TrevM309/RC8266_RCController_PCB_RcCtl/RcCtlHwParts.xlsx

Ref | Description | Name | Package | Num | Got | Source | Order | Cost £ | Price | got | onorder
U1 | Charging IC | TP4056 | SOP-8 | 1 | y | AliExpress | 20 | 0.76 | 0.038 | 18
U2 | Main IC | ESP-M2 | ESP-M2 | 1 | y | AliExpress | 1 | 1.11 | 1.11 | 6
U3 | I2C to 4 x ADC | ADS1015 | MSOP10 | 1 | y | AliExpress | 5 | 4.35 | 0.87 | 3 | 20 | aliexpress
V1 | 3V3 regulator | BA033CC0FP-E2 | TO252-3 | 1 | y | Farnell | 1 | 0.87 | 0.87 | 1 | 10 | farnell
V2 | 2V8 regulator | MIC5365-2.8YC5-TR | SC-70-5 | 1 | y | Farnell | 5 | 0.56 | 0.112 | 2 | 10 | farnell
D1 | RGB common cathode LED |  | 5mm | 1 | y | AliExpress | 100 | 7.19 | 0.0719 | 98
R1,3 | 1K2 Resistor | MCWR08X1201FTL | 0805 | 2 | y | Farnell | 1 | 0.008 | 0.016 | 15
R2 | 0R4 1/2w Resistor | WW25PR400FTL | 2512 | 1 | y | Farnell | 10 | 3.75 | 0.375 | 6
R6,7,8 | 10K Resistor | 2074334 | 0805 | 5 | y | Farnell | 10 | 0.195 | 0.0975 | 23
C1,2,3,4 | 10uF 10V Capacitor | C2012X6S1A106K085AC | 0805 | 4 | y | Farnell | 10 | 0.54 | 0.216 | 2 | 10 | farnell
C5,6 | 100nF Capacitor | MC0805B104M500CT | 0805 | 2 | y | Farnell | 10 | 0.52 | 0.104 | 13
BT1 | 3V7 LiPo Battery | 652338 6.5*23*38mm |  | 1 | y | AliExpress | 2 | 4.64 | 2.32 | 3
SW1 | Small slide switch |  |  | 1 | y | BangGood | 10 | 2.44 | 0.244 | lots
RV1,2 | Joystick |  |  | 1 | y | BangGood | 1 | 2.26 | 2.26 | 2 | 6 | aliexpress
J1 | Mini USB connector |  |  | 1 | y | Ebay | 10 | 1.31 | 0.131 | 7
J2 | Program port | 5 pin header |  | 0.12 | y | BangGood | 10 | 1.63 | 0.020375 | lots
J3 | LCD flexi connector | TE 2328702-8-FFC/FPC |  | 1 | y | Farnell | 5 | 0.86 | 0.172 | 2 | 10 | farnell
J3 | 0.96" 80x160 IPS TFT |  |  | 1 | y | AliExpress | 2 | 2.66 | 1.33 | sipeed langan nano | 5 | aliexpress
 |  |  |  |  |  |  |  |  | 10.357775
