TrevM309/RC8266_RCController_PCB_RcCtl/RcCtlHw.kicad_pcb

## KiCad design RcCtlHw.kicad_pcb (2021-08-10)

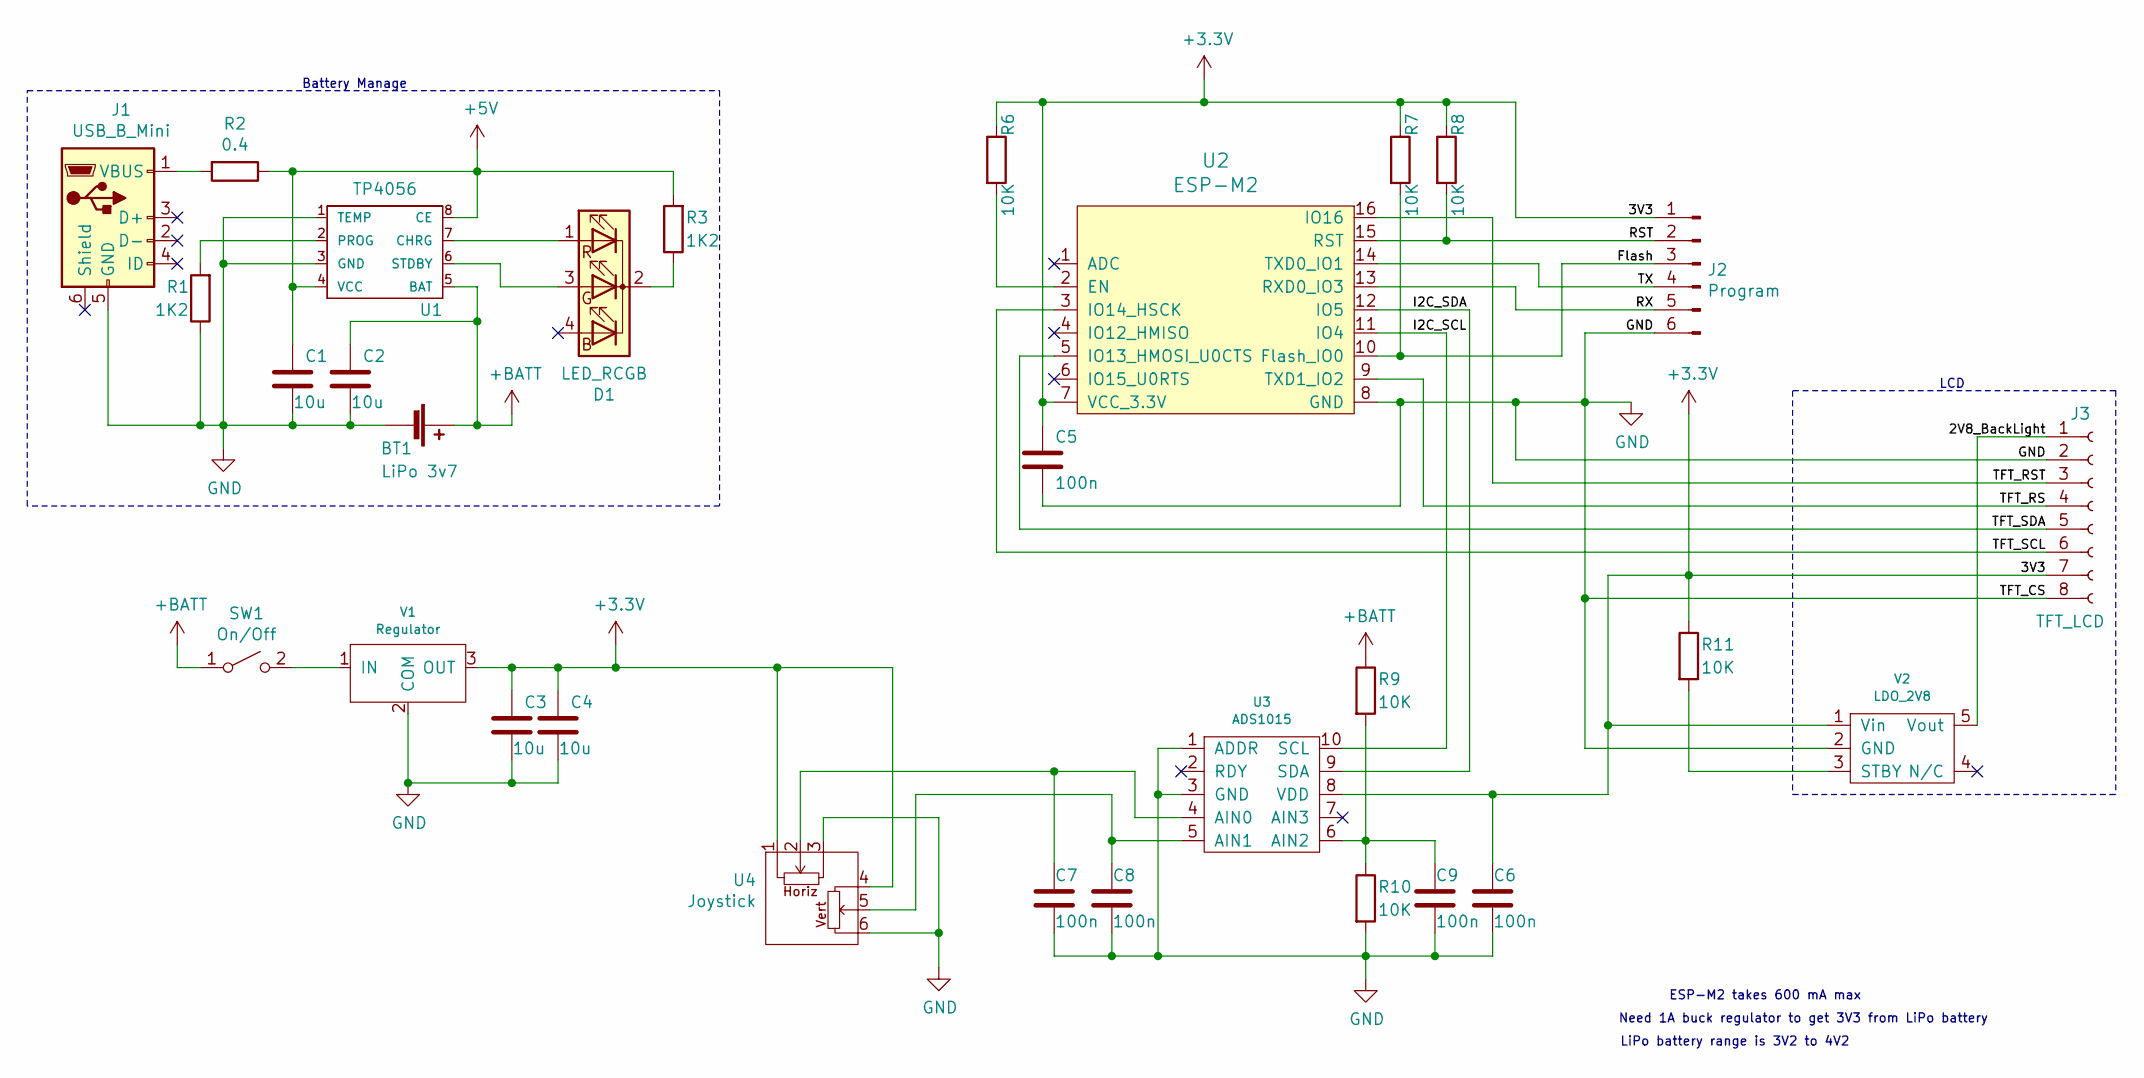
[picture p1: schematic RcCtlHw.sch]

Parts:
BT1: LiPo 3v7; PinHeader_1x02_P2.54mm_Vertical
C1, C2, C3, C4: 10u; C_0805_2012Metric
C5, C6, C7, C8, C9: 100n; C_0805_2012Metric
D1: LED_RCGB; LED_D5.0mm-4_RGB-RIGHT
J1: USB_B_Mini; USB_micro
J2: Program; PinHeader_1x06_P2.54mm_Vertical_bent
J3: TFT_LCD; 8w_FFC_conn
R1, R3: 1K2; R_0805_2012Metric
R2: 0.4; R_2512_6332Metric
R6, R7, R8, R9, R10, R11: 10K; R_0805_2012Metric
SW1: On/Off; SlideSwitch
U1: TP4056; SOP-8_3.9x4.9mm_P1.27mm
U2: ESP-M2; ESP-M2_DOIT
U3: ADS1015; MSOP-10_3x3mm_P0.5mm
U4: Joystick
V1: Regulator; TO-252-2
V2: LDO_2V8; SOT-353_SC-70-5

Connections:
+3V3: C3.1, C4.1, C5.1, C6.1, J2.1, J3.7, R6.1, R7.1, R8.1, R11.1, U2.7 (VCC_3.3V), U3.8 (VDD), U4.1, U4.4, V1.3 (OUT), V2.1 (Vin)
+BATT: BT1.1 (+), C2.1, R9.1, SW1.1 (A), U1.5 (BAT)
/2V8_BackLight: J3.1, V2.5 (Vout)
/Flash: J2.3, R7.2, U2.10 (Flash_IO0)
/I2C_SCL: U2.11 (IO4), U3.10 (SCL)
/I2C_SDA: U2.12 (IO5), U3.9 (SDA)
/RST: J2.2, R8.2, U2.15 (RST)
/RX: J2.5, U2.13 (RXD0_IO3)
/TFT_RS: J3.4, U2.9 (TXD1_IO2)
/TFT_RST: J3.3, U2.16 (IO16)
/TFT_SCL: J3.6, U2.3 (IO14_HSCK)
/TFT_SDA: J3.5, U2.5 (IO13_HMOSI_U0CTS)
/TX: J2.4, U2.14 (TXD0_IO1)
GND: BT1.2 (-), C1.2, C2.2, C3.2, C4.2, C5.2, C6.2, C7.2, C8.2, C9.2, J1.5 (GND), J2.6, J3.2, J3.8, R1.1, R10.2, U1.1 (TEMP), U1.3 (GND), U2.8 (GND), U3.1 (ADDR), U3.3 (GND), U4.3, U4.6, V1.2 (COM), V2.2 (GND)
unnamed: C1.1, R2.1, R3.2, U1.4 (VCC), U1.8 (CE)
unnamed: C7.1, U3.4 (AIN0), U4.2
unnamed: C8.1, U3.5 (AIN1), U4.5
unnamed: C9.1, R9.2, R10.1, U3.6 (AIN2)
unnamed: D1.1 (RA), U1.7 (CHRG)
unnamed: D1.2 (K), R3.1
unnamed: D1.3 (GA), U1.6 (STDBY)
unnamed: J1.1 (VBUS), R2.2
unnamed: R1.2, U1.2 (PROG)
unnamed: R6.2, U2.2 (EN)
unnamed: R11.2, V2.3 (STBY)
unnamed: SW1.2 (B), V1.1 (IN)

Notes on the sheet:
Battery Manage
LCD
LiPo battery range is 3V2 to 4V2
Need 1A buck regulator to get 3V3 from LiPo battery
ESP-M2 takes 600 mA max

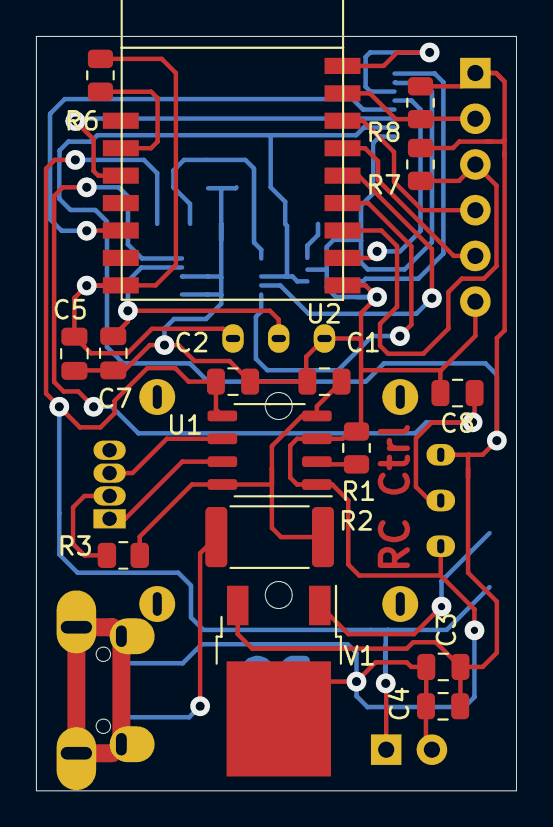
[picture p2: board RcCtlHw.kicad_pcb from above]

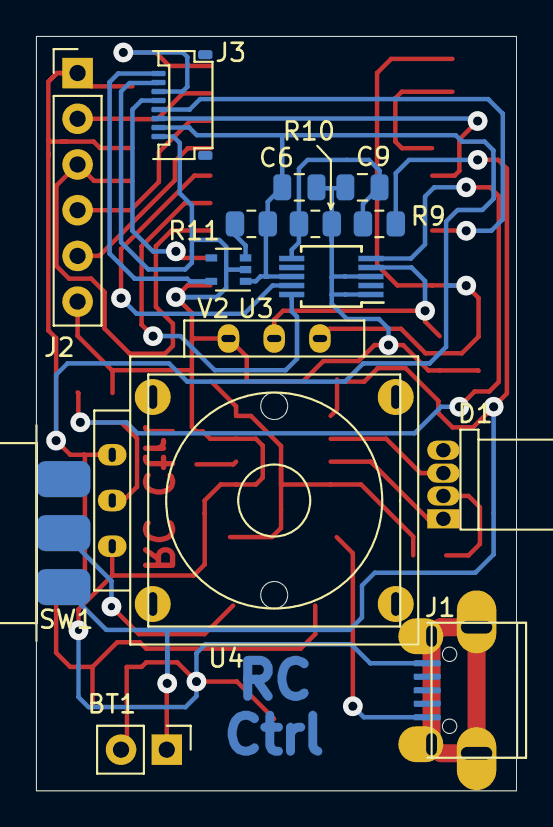
[picture p3: board RcCtlHw.kicad_pcb from below]

Board: 2 copper layers, 26.7 x 41.9 mm, 30 parts (14 on the bottom side), 26 nets.
