TrevM309/RC8266_RCController_PCB_RcCtl/(commit log)

2021-05-12 1st attempt (not good)
    [RcCtlHw.kicad_pcb, RcCtlHw.sch, RcCtlHwParts.xlsx]
2021-05-14 2nd attempt, looking good
    [RcCtlHw.kicad_pcb, RcCtlHw.sch]
2021-05-14 Small tweaks after creating good pcb
    [RcCtlHw.kicad_pcb]
2021-05-22 Re-Design with big changes for TFT connection
    [RcCtlHw.kicad_pcb, RcCtlHw.sch]
2021-05-24 TFT_CS now connected GND, GPIO5 back to I2C_SDA PCB linked, mostly working USB connector beefed
    [RcCtlHw.kicad_pcb, RcCtlHw.sch]
2021-05-25 beefed up USB connector mountings, joystick now swings GND to 3V3 on H & V
    [RcCtlHw.kicad_pcb, RcCtlHw.sch]
2021-05-25 update BOM £10.36 each
    [RcCtlHwParts.xlsx]
2021-05-29 Re-worked USB connector and Joystick to allow oval holes for legs Cleaned up tracks
    [RcCtlHw.kicad_pcb, RcCtlHw.sch]
2021-05-30 update BOM spreadsheet with current stock
    [RcCtlHwParts.xlsx]
2021-06-06 Playing 3D, no real change
    [RcCtlHw.kicad_pcb]
2021-06-06 More 3D play
    [RcCtlHw.kicad_pcb, RcCtlHw.sch]
2021-06-19 Added 100n capacitors to ADCs
    [RcCtlHw.kicad_pcb, RcCtlHw.sch]
2021-06-20 Clean up silk screens
    [RcCtlHw.kicad_pcb]
2021-06-20 Space things out
    [RcCtlHw.kicad_pcb]
2021-06-20 pre etch tweaks
    [RcCtlHw.kicad_pcb]
2021-06-21 Files for PCB Manufacture
    [RcCtlHw-B_Cu.gbr, RcCtlHw-B_Mask.gbr, RcCtlHw-B_SilkS.gbr, RcCtlHw-F_Cu.gbr, RcCtlHw-F_Mask.gbr, RcCtlHw-F_SilkS.gbr, RcCtlHw-NPTH.drl, RcCtlHw-PTH.drl]
2021-07-26 Move switch to before regulator
    [RcCtlHw.kicad_pcb, RcCtlHw.sch]
2021-08-10 small silk screnn clarification
    [RcCtlHw.kicad_pcb]
2021-09-18 Remove Elecrow specific files (out of date)
    [RcCtlHw.GBL, RcCtlHw.GBO, RcCtlHw.GBS, RcCtlHw.GTL, RcCtlHw.GTO, RcCtlHw.GTS]
2021-09-18 Updated gerber files
    [RcCtlHw-B_Adhes.gbr, RcCtlHw-B_CrtYd.gbr, RcCtlHw-B_Cu.gbr, RcCtlHw-B_Fab.gbr, RcCtlHw-B_Paste.gbr, RcCtlHw-B_SilkS.gbr, RcCtlHw-Edge_Cuts.gbr, RcCtlHw-F_Adhes.gbr]
